explosionraptors/CSEE-4920/Schematics-Diagrams/arduinorfid_bb.png

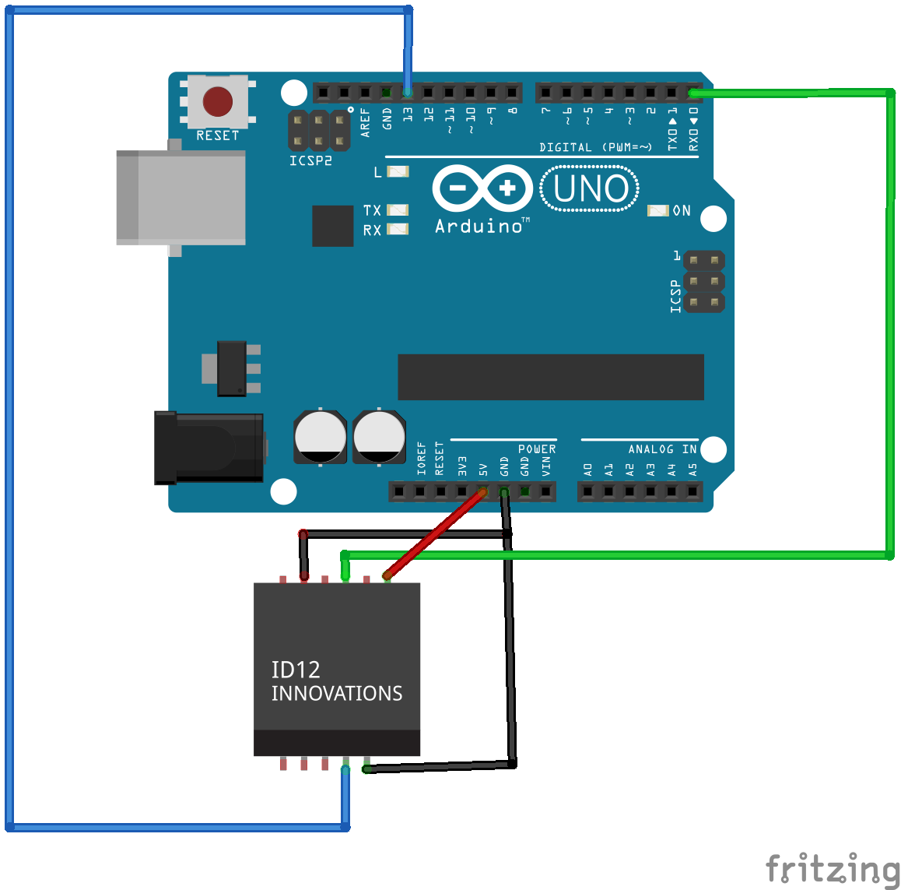
Schematics-Diagrams/arduinorfid_bb.png
