explosionraptors/CSEE-4920/Schematics-Diagrams/arduinorfid_schem.png

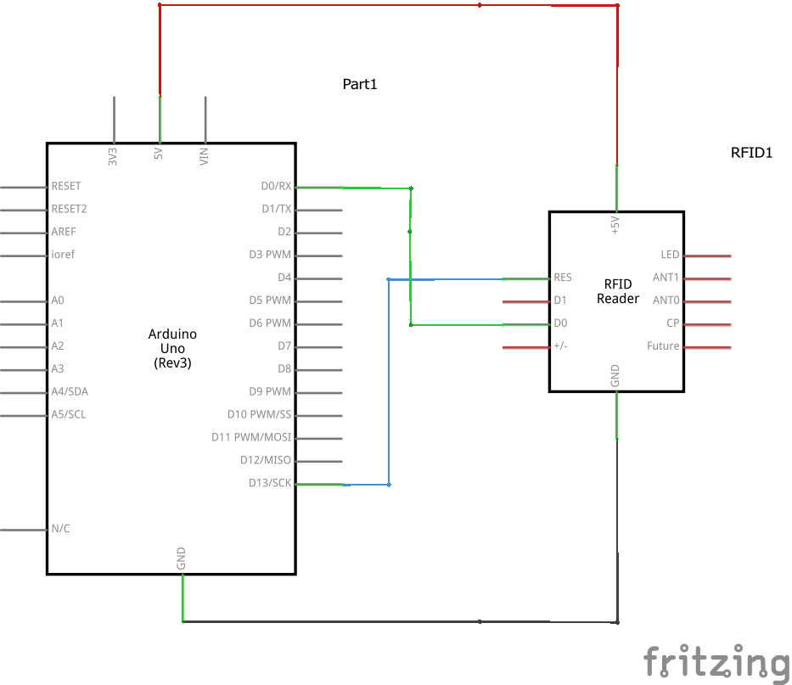
Schematics-Diagrams/arduinorfid_schem.png
