explosionraptors/CSEE-4920/Schematics-Diagrams/motorboxcad.PNG

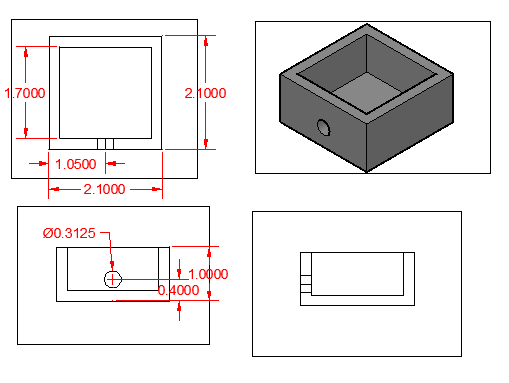
Schematics-Diagrams/motorboxcad.PNG
