explosionraptors/CSEE-4920/Schematics-Diagrams/motorcontrol_bb.png

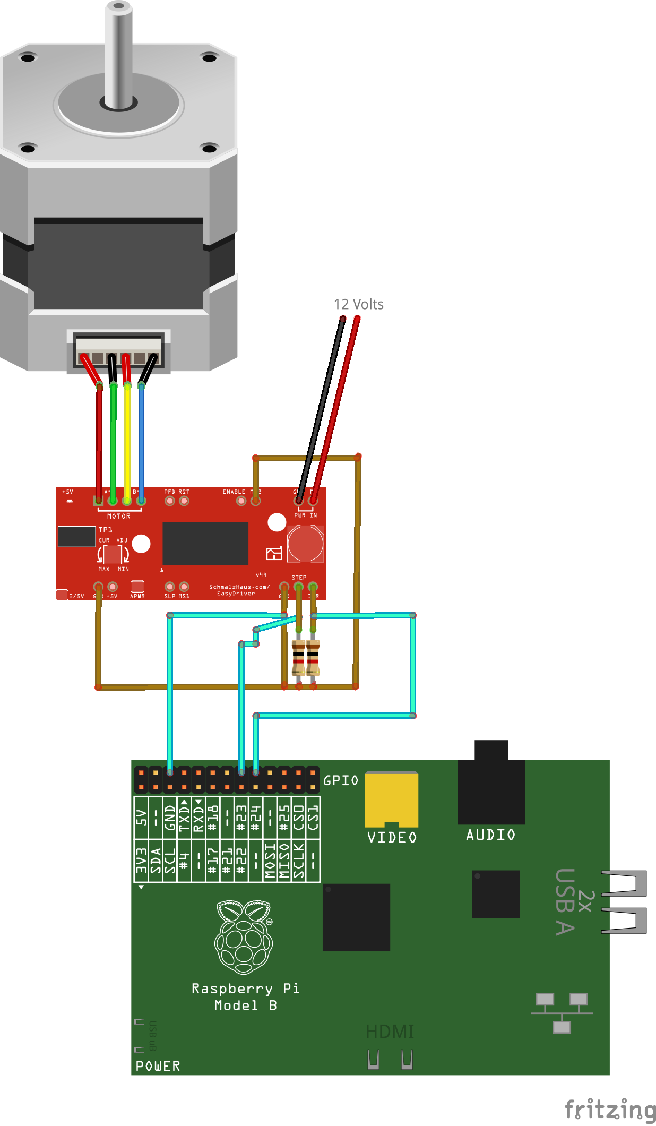
Schematics-Diagrams/motorcontrol_bb.png
