explosionraptors/CSEE-4920/Schematics-Diagrams/motorcontrol_schem.png

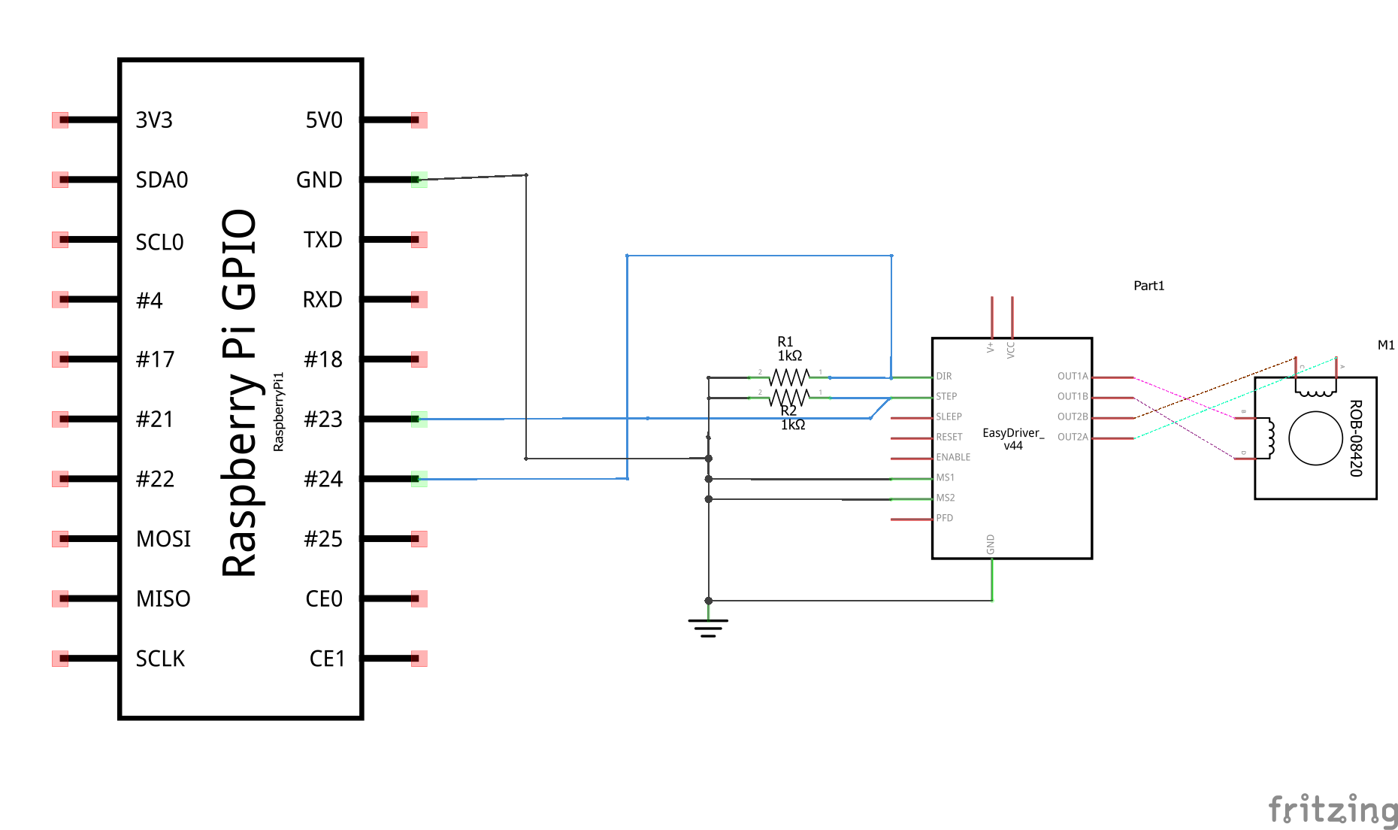
Schematics-Diagrams/motorcontrol_schem.png
