explosionraptors/CSEE-4920/Schematics-Diagrams/motorcontrolandrfidBreadboard_bb.png

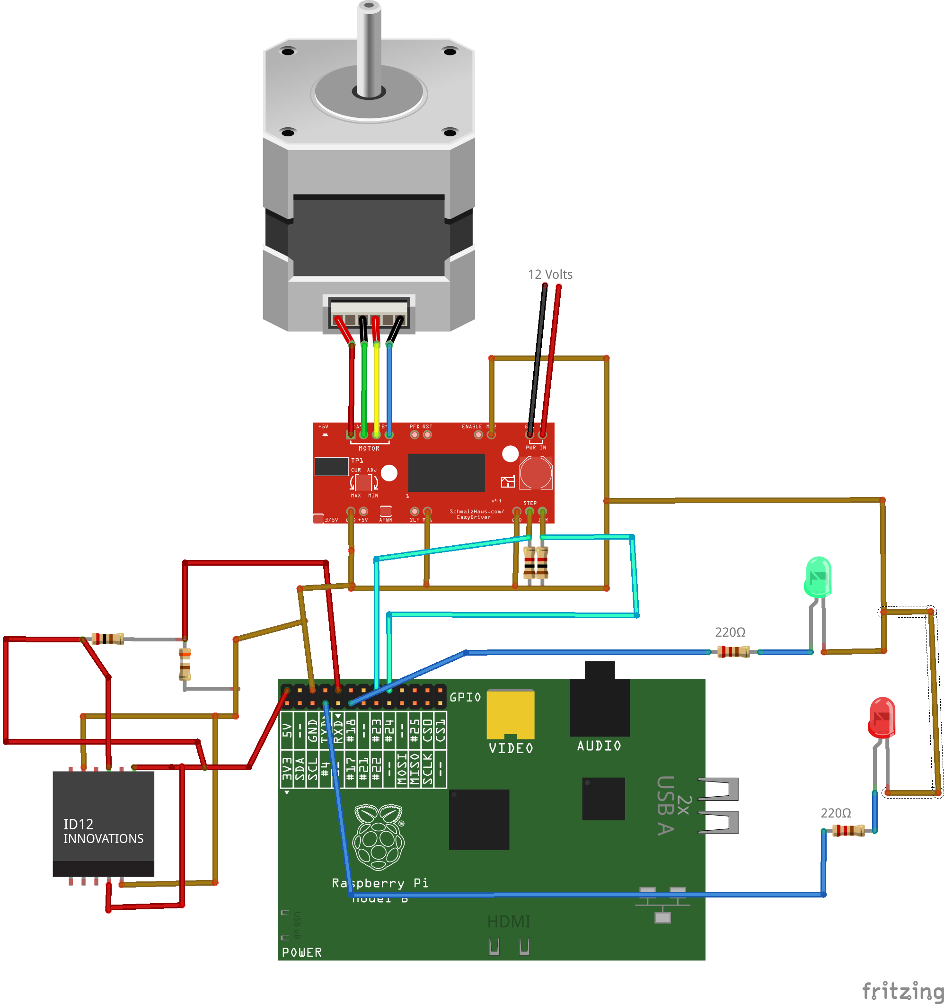
Schematics-Diagrams/motorcontrolandrfidBreadboard_bb.png
