explosionraptors/CSEE-4920/Schematics-Diagrams/motorcontrolandrfidspng_schem.png

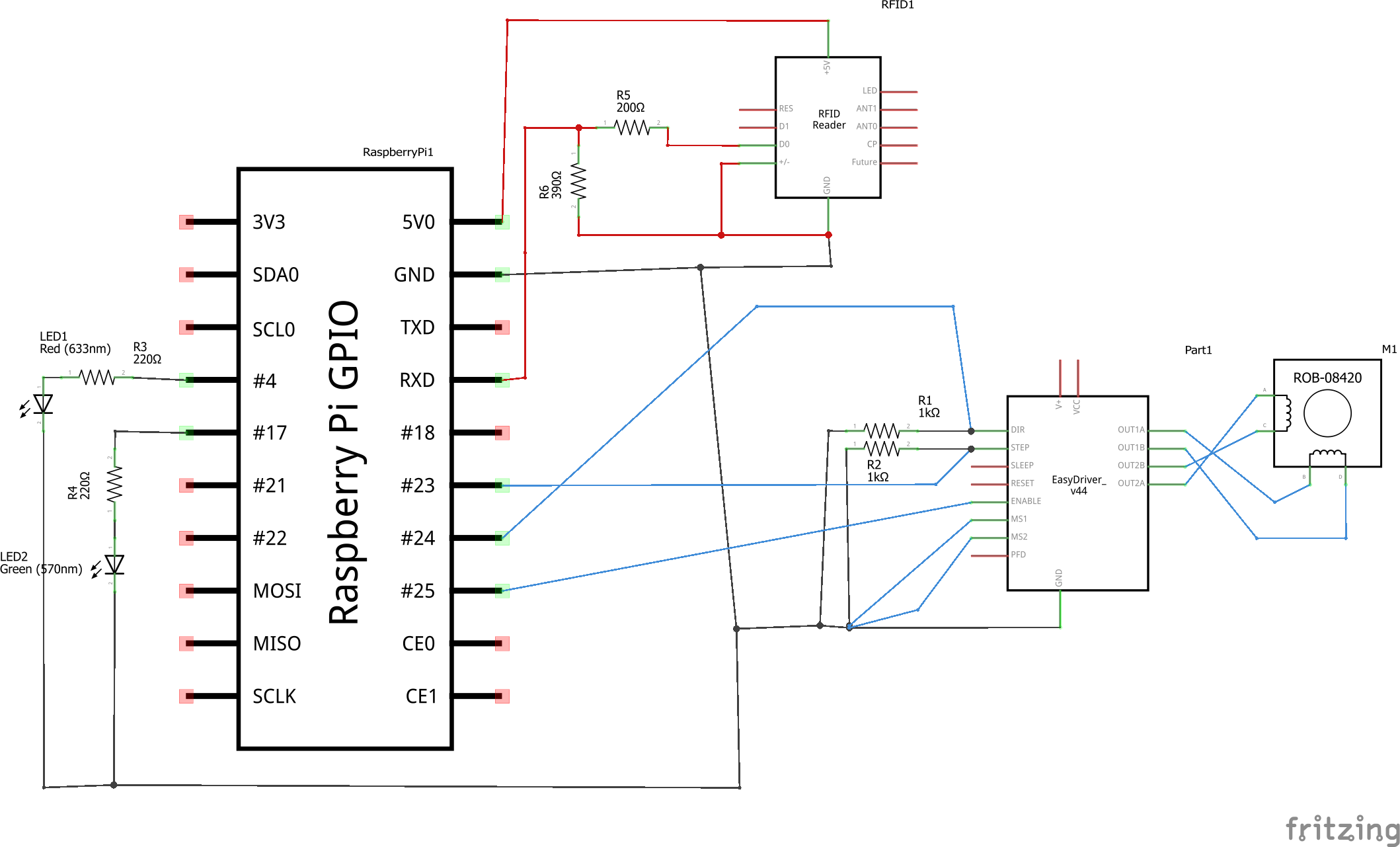
Schematics-Diagrams/motorcontrolandrfidspng_schem.png
