explosionraptors/CSEE-4920/poster/Cost Analysis.xlsx

Cost Analysis
Electronics
Parts | Manufacturer | Model Number | Quantity | Unit Cost (<100) | Unit Cost (>100) | Total (<100) | Total (>100) | Link
RFID Reader ID-12LA (125kHz) | Innovations | SEN-11827 | 1 | $29.95 | $23.96 | $29.95 | $23.96 | https://www.sparkfun.com/products/11827
Easydriver Motor Controller | Sparkfun/Schmalz Haus LLC | ROB-10267 | 1 | $14.95 | $11.96 | $14.95 | $11.96 | https://www.sparkfun.com/products/10267
Rechargeable Battery Pack | XTPower | MP-10000 | 1 | $47.90 | $47.90 | $47.90 | $47.90 | http://www.amazon.com/XTPower-10000mAh-Recorders-Sensation-Connectors/dp/B00935L44E
Raspberry Pi Microcontroller | RS Components | Model-B Rev. 1 | 1 | $35.00 | $35.00 | $35.00 | $35.00 | http://www.alliedelec.com/lp/120626/rasomodelb/
Hook-up Wire - (White) (22AWG) | Generic/OEM | PRT-08026 | 1 | $2.50 | $2.00 | $2.50 | $2.00 | https://www.sparkfun.com/products/8026
802.11b/g/n Nano USB Wifi Adapter Dongle for Raspberry Pi (Ralink RT5370) | Ralink | RT5370 | 1 | $6.18 | $6.18 | $6.18 | $6.18 | http://www.amazon.com/802-11n-150m-Wireless-Network-Adapter/dp/B007BWFXYS
LED - Basic Red 5mm | Generic/OEM | COM-09590 | 1 | $0.35 | $0.28 | $0.35 | $0.28 | https://www.sparkfun.com/products/9590
Wheelwatcher Encoder for Gearhead Motors | Nubotics | WW-12 | 1 | $19.95 | $19.95 | $19.95 | $19.95 | http://store.nubotics.com/store/product.php?productid=3
Subtotal |  |  |  |  |  | $156.78 | $147.23
Mechanical
Stepper Motor with Cable | Generic/OEM | ROB-09238 | 1 | $14.95 | $11.96 | $14.95 | $11.96 | https://www.sparkfun.com/products/9238
Universal Aluminum Mounting Hub for 5mm Shaft, #4-40 Holes (2-Pack) | Pololu | 1203 | 1 | $7.49 | $5.62 | $7.49 | $5.62 | http://www.pololu.com/product/1203
3/4-In x 10-Ft 480 Psi Schedule 40 Pvc Pressure Pipe | Charlotte Pipe | PVC 04007 0600 | 1 | $2.19 | $2.19 | $2.19 | $2.19 | http://www.lowes.com/pd_23971-1814-PVC+04007++0600_4294822019__?productId=3133085
1/4-in x 36-in Standard (SAE) Threaded Rod | The Hillman Group | 11009 | 1 | $1.82 | $1.82 | $1.82 | $1.82 | http://www.lowes.com/pd_69886-37672-11009_0__?Ntt=69886&UserSearch=69886&productId=3129279&rpp=48
1/4-in-20 Hot-Dipped Galvanized Standard (SAE) Hex Nut | The Hillman Group | 810503 | 4 | $0.14 | $0.14 | $0.56 | $0.56 | http://www.lowes.com/pd_67340-37672-810503_4294934474__?productId=3037534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
Subtotal |  |  |  |  |  | $27.01 | $22.15
Grand Total |  |  |  |  |  | $183.79 | $169.38
Sliding Lock (3-Pack) | Dreambaby | L183 | 1 | $4.47 | $4.47 | $4.47 | $4.47 | http://www.lowes.com/pd_442101-48755-L183_0__?productId=4682677
