explosionraptors/CSEE-4920/(list of files, cad)

Other CAD files:
Schematics-Diagrams/motorbox.dwg
