explosionraptors/CSEE-4920/(list of files, drawings)

Other design files:
archive/arduinorfid.fzz
archive/motorcontrol.fzz
Schematics-Diagrams/arduinorfid.fzz
Schematics-Diagrams/motorcontrol.fzz
Schematics-Diagrams/motorcontrolandrfid.fzz
Schematics-Diagrams/motorcontrolandrfids_schem.fzz
