explosionraptors/CSEE-4920/(commit log)

2014-03-31 Create Motor Module
2014-04-01 Schematics and Diagrams on how to wire the hardware
2014-04-02 Fritzing Files for Motor and RFID
    [arduinorfid.fzz, motorcontrol.fzz]
2014-04-02 Revert "Fritzing Files for Motor and RFID"
    This reverts commit 7afc6329089e7fd44c1a10b73642a16011c90123.
    [arduinorfid.fzz, motorcontrol.fzz]
2014-04-02 Motor and RFID Fritzing files
    [arduinorfid.fzz, motorcontrol.fzz]
2014-04-02 Revert "Motor and RFID Fritzing files"
    This reverts commit 36756bd4a4a15e4fa93bc68c9186a71112f73a5b.
    [arduinorfid.fzz, motorcontrol.fzz]
2014-04-02 Fritzing Documents for Motor and RFID modules
    Fritzing Documents for Motor and RFID modules
    [arduinorfid.fzz, motorcontrol.fzz]
2014-04-13 Database integration, motor additions, rfid additions, main rewrite
2014-04-14 Basic led support (states)
2014-04-16 Schematic changes
    Updated with new schematics. Archived old schematics
    [arduinorfid.fzz, motorcontrol.fzz, motorcontrolandrfid.fzz, motorcontrolandrfids_schem.fzz]
2014-04-17 encoder integration
2014-04-20 Robotic Doorman Project Cost Analysis
    Format shamelessly borrowed from Automated Bike Share Project. Dummy
    values for prices/quantities.
    [Cost Analysis.xlsx]
2014-04-23 (0.75) Cost Analysis
    Almost done! Took a few liberties on the item sources (defaulted to
    sparkfun when possible), but it's mostly all there. Still need an entry
    for the shaft clamp.
    [Cost Analysis.xlsx]
2014-04-23 Cost Analysis Done
    But feel free to double check my work.
    [Cost Analysis.xlsx]
2014-05-07 Cad drawings of motor enclosure
    [motorbox.dwg]
2014-05-07 updated schematics
    [motorcontrolandrfid.fzz, motorcontrolandrfids_schem.fzz]
